cborrowman/Napco1632ArduinoMonitor/README.md

# Napco1632ArduinoMonitor
------------------------------------------------------------------------------
April 24, 2026

I've been running the Arduino MKR 1010 WIFI/Arduino MKR Ethernet combo for a couple years now and it's been fairly reliable. It does restart occasionally, which I think is due to the 8 second watchdog timer expiring due to some delay posting to the azure site I am collecting data. 

I don't use HTTPS because the handshakes were taking 7-8 seconds and require preloading a certificate trust chain that I would have to flash to maintain over time. You need to use encryption, so I found it to be much faster to encrypt data on the arduino using a hardcoded key and send the encrypted data over HTTP rather than attempting to do TLS directly on the Arduino. I'm willing to accept the risk of this for a hobbyist solution.

I wanted to have a cellular fallback and have spent time exploring options to do that. I looked at the [SparkFun LTE CAT M1/NB-IoT Shield - SARA-R4](https://www.sparkfun.com/sparkfun-lte-cat-m1-nb-iot-shield-sara-r4.html) although I never had much success with it. I could get a few connections and send a little data, but would also go through days of total failure. It never became a reliable option.

I also tried the [Arduino MKR NB 1500](https://store-usa.arduino.cc/products/arduino-mkr-nb-1500) cellular option and had similar results as the SparkFun. It worked occasionally but it then seems like a total failure. I think I even replaced the Arduino board at one point but never made much headway.

I recently came across the [Walter](https://www.quickspot.io/) cellular modem device. An ESP32 based board with WIFI and LTE. It worked right out of the box. I experimented with it for a couple months. Its software library was upgraded a few times and seems like a stable platform.

The idea occurred to me to build a cellular proxy device using the WalterModem. I would add a LAN connection and any devices in my house could send their payload to this device over LAN, it would attempt to repost the request via LAN, if that fails it would try WIFI, and if that fails it would fallback to Cellular/LTE. I spent a few months building and testing this. Looking at the entire picture, I grew dissatisfied with the proxy plan. It meant I'd have to provide battery backup power to all devices that need to send data, and likely some portion of the network, at least one router, in case of a power outage. While this could work, it seemed impractical and cumbersome.

I had a fairly complicated script for Arduino and the thought of rewriting it for ESP32 didn't sound like fun, so I initially did not consider porting my alarm monitor implementation to run on the Walter. I started experimenting with a W5500 LAN controller and once I got that working it seemed pretty straightforward to see if the Walter could handle the other IO needed for the alarm monitor.

The hardware interface was nearly identical to what I used on Arduino. Copilot with Claude Sonnet made the migration to Walter effortless. I started by having it create a detailed plan and it actually suggested several additions I had not considered, such as recording reboot reason and other diagnostic information. I also had it implement a number of test modes so I could confirm each of the transport platforms was working.

This schematic iteration shows routing both the alarm panel transmit and the keypad transmit data as inputs. I was using this briefly to sniff and compare the wire traffic. I ended up using only the panel transmit data for monitoring.

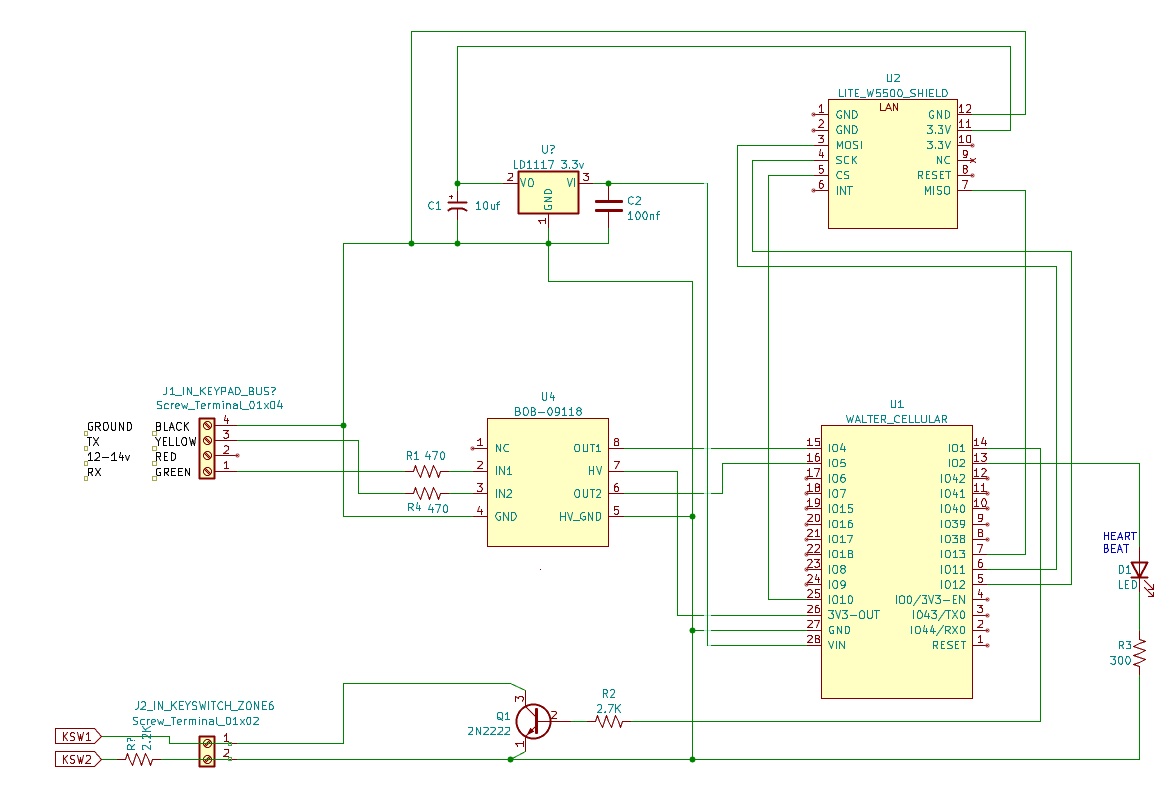
[picture p1: images/WalterW5500KeyswitchWithLTEFallback.jpg]
Walter With Fallback Schematic


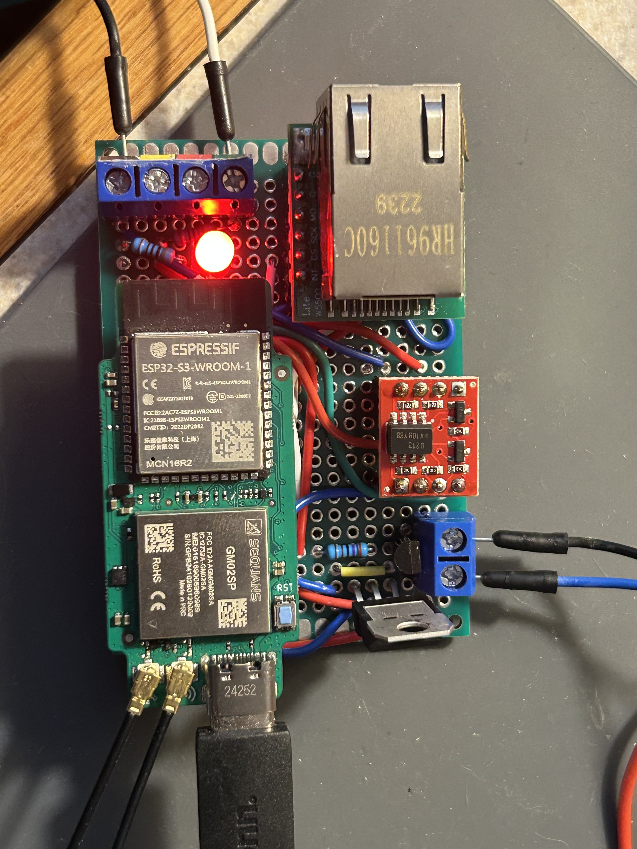
[picture p2: images/WalterW5500Fallback.jpg]
Walter With Fallback Photo


It took a little effort getting the transport fallback to work correctly. Fortunately I had a home internet outage at just the right time and was able to test. Of course the first tests failed but with a little work I ended up with a reliable fallback scheme. It tries to publish to the server first via LAN, if that is disconnected or fails, it will try WIFI. If that isn't online or fails it will then try cellular LTE. Worst case is about 6 seconds failing on LAN and WIFI. Running this for a couple weeks I still see some fail overs to cellular throughout the day.

I'm using a sim from [Hologram](https://www.hologram.io/). Minimal data usage is about $1 per month.

I really like the Walter and am thinking of other uses where I'd like to fallback to cell communication.

------------------------------------------------------------------------------
April 21, 2023

One day I was looking at other integrated alarm ideas and came across one solution that used keyswitch arming to trigger arming and disarming of the control panel. I wish I had found this earlier because it makes for a much simplier solution. Rather than having to read and write to the panel and also and inject my own commands in bewteen responses from a real keypad, all it has to do is monitor the panel output. Then to trigger arm/disarm it only needs to ground two pins on the panel.

I had an earlier prototype board sitting on the bench that was readonly and used just for monitoring. I experimented with using a simple transistor to pull the keyswitch contacts low it worked, so I turned this board into Schematic 6 and Prototype 6.

All the code I had previouslt could be used, except I didn't need any of the code to write commands back. Triggering the keyswitch just required a one second pulse to low on the digital output driving the transistor.

The last prototype has been very stable and has been running since December. I do seem to go through episodes of rebooting a few times a day, some days more than others. I think the issues are more about sending commands to the azure site recording alarm status. I think the reboots are ocurring because the command cannot be delivered to the azure site within 8 seconds. I don't think it is because the board is crashing and rebooting. I have an 8 second watch dog running, so if any command takes longer than 8 seconds, the board resets. I see 2 or 3 a day.

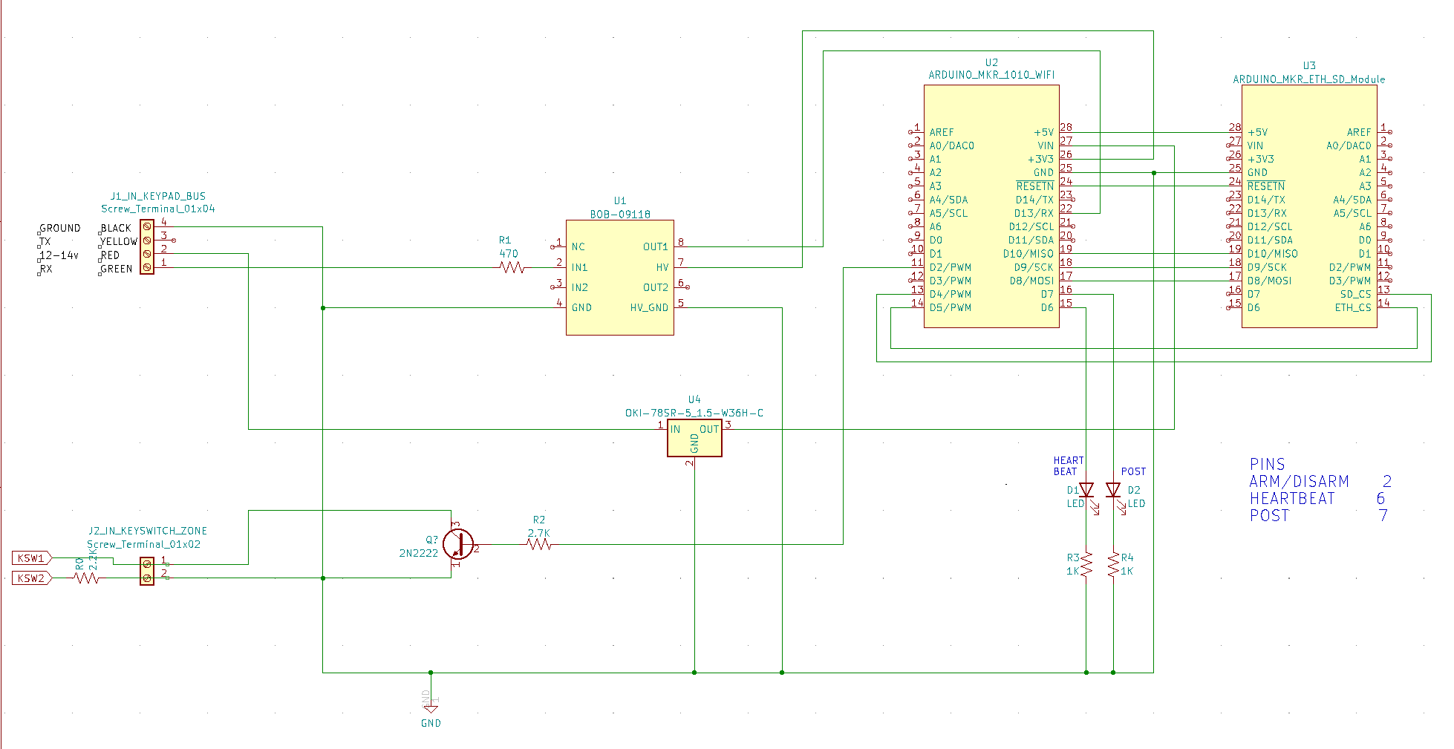
[picture p3: images/schematic6.png]
Prototype6


------------------------------------------------------------------------------
December 17, 2022

I've been experimenting with ethernet adaptors trying to find a reliable wired ethernet connection. I tried replacing the 7805 power supply with an OKI 78SR5 power convertor. This uses solid state switching to regulate power and won't have the same power usage as the 7805. I thought the 7805 was getting rather hot. I seem to have a problem with bootup power. I ended up just using a USB power supply for the Arduino & ethernet.

This lead to Schematic 5 and Prototype 5 shown below:
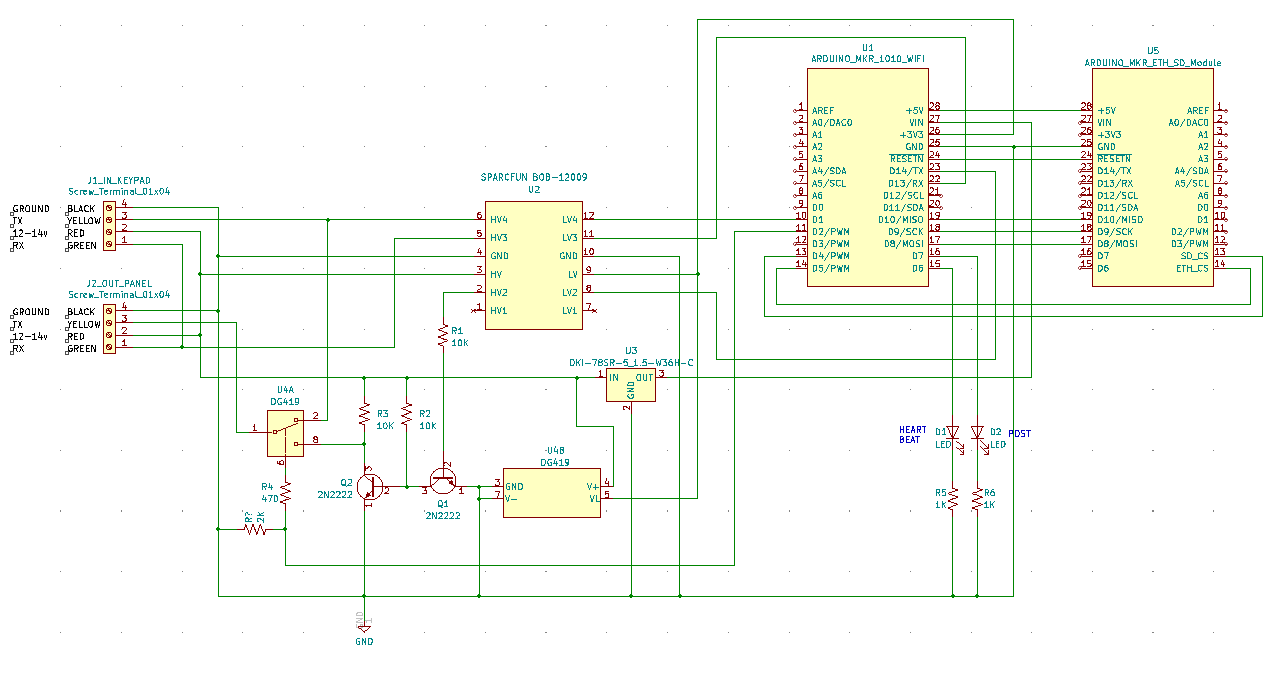
[picture p4: images/Schematic5.png]

<br/>
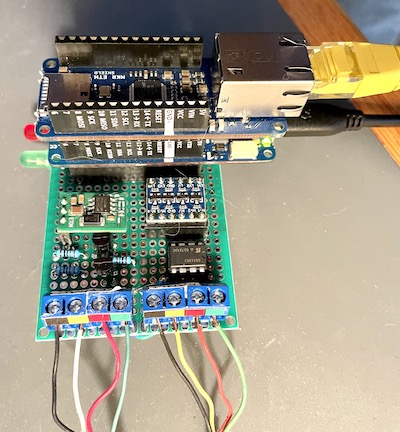
[picture p5: images/Prototype5.jpg]
Prototype2


I had added two LEDs to show a heatbeat blink and a post light. This provided some feedback that the unit was operating. I didn't realize at first that I had a conflict between the Arduino and the ETH shield. I had an LED wired to digital pins 4 & 5. The MKR ETH shield was using pi 4 as CS for the card reader.

I think this was the source of some of my problems. I had code turning the LED on and off and this was likely causing CS signal conflicts.

------------------------------------------------------------------------------
November 6, 2022

The alarm monitor has been running for several months using WIFI to communicate with the server site. Once I added a routine to reset and restart the WIFI module when it cannot connect, it’s been reliable. 

It reports status every 5 minutes if there is no other status to send, so the server will detect if the alarm is offline if it doesn’t hear anything for 6 minutes. I was getting offline reports once or twice a day, but it would always be back online within 1-2 minutes. I’m not sure of the cause of this. It could be WIFI connection, although I’ve got a Google mesh network that seems very reliable. 

It could be a bug that prevents it from sending on time. Monitoring the log for extended periods of time I was surprised to see how much time it was taking to send a message via SSL.

WIFI message sends over SSL were taking 3+ seconds, which seems like a very long time. I measured a few that took 4-7 seconds. I had to set the watchdog timer to 8 seconds to avoid resetting the monitor if the send takes too long. I don’t think this was the cause of going offline because the monitor sends a power on message when it boots and there was no log of this.

I figured I would switch to wired ethernet since i already had a network line run to the panel. I purchased an Arduino MKR ETH Shield which plugged directly into the Arduino MKR WIFI 1010 I am using. I thought this would be a simple change to the code. 

Although the MKR WIFI 1010 has a special ship to hold certificate secrets, I didn’t find any libraries which could use this for Ethernet. I did eventually find a library that could handle SSL over ethernet. These messages were taking over 7 seconds to make the SSL connection! I’m surprised at the state of SSL. it seems current SSL encryption requires too much computation. Regular HTTP is pretty quick, usually less than one second. 

I considered just using HTTP, however the Azure Static Web Site doesn’t accept HTTP connections. I started experimenting with doing some lightweight encryption on the Arduino and found a library that could do AES 128 quickly. This would be good enough for alarm status data. I created an Azure function that accepted an encrypted POST from the Arduino on HTTP and would decrypt and forward to the normal status API.

This allowed posts to occur under one second, typically around 600ms including the encryption. This was good enough.

I plugged in the ethernet shield to the live monitor and updated the software. It was working for for about one hour when it went offline. It didn’t come back online like before. I connected the computer to view the log output and it booted up and started running. I suspect the 7805 voltage regulator powering the Arduino just could not handle both the Arduino and ethernet shield. It got too hot and shutdown.

I plugged in a USB power supply to the usb cable to take the load off the voltage regulator. It ran for about one day and then stopped, and again the Arduino appeared to be hung since it booted when I connected the mac. 
 
I put the WIFI code back in place and proceeded to investigate power and ethernet options.

------------------------------------------------------------------------------
June 1, 2022

Hit an important milestone today! I can connect to a website that displays the panel buttons virtually. I can enter codes and arm and disarm as needed! Panel responds immediately. Switching hardware is working perfectly.

Here's a couple photos of the website - works on my mac and iphone:

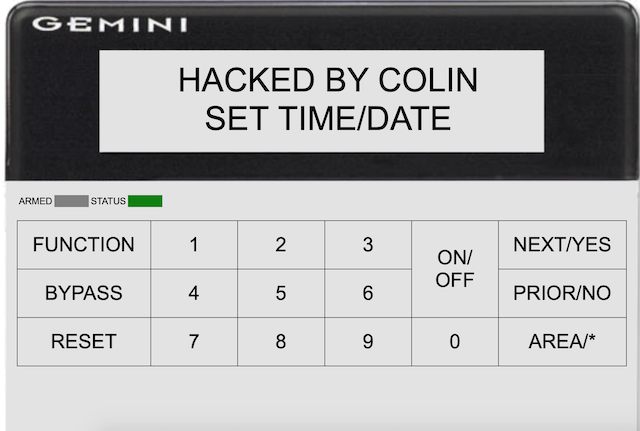
[picture p6: images/disarmed.png]

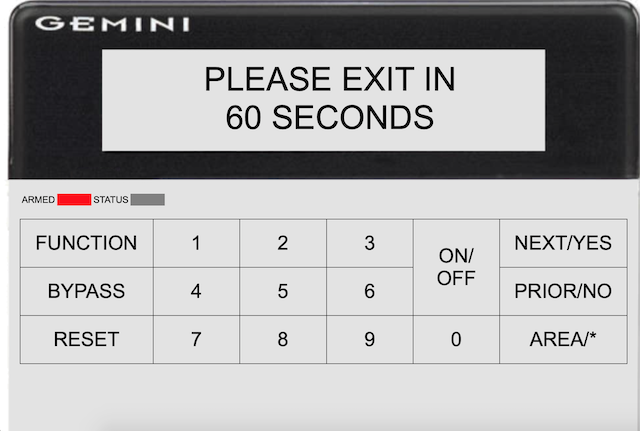
[picture p7: images/armed.png]


Below is a screenshot of the transmit line and the switching signal. At this point I am transmitting a custom command to the panel from the website. For example, to arm or disarm:

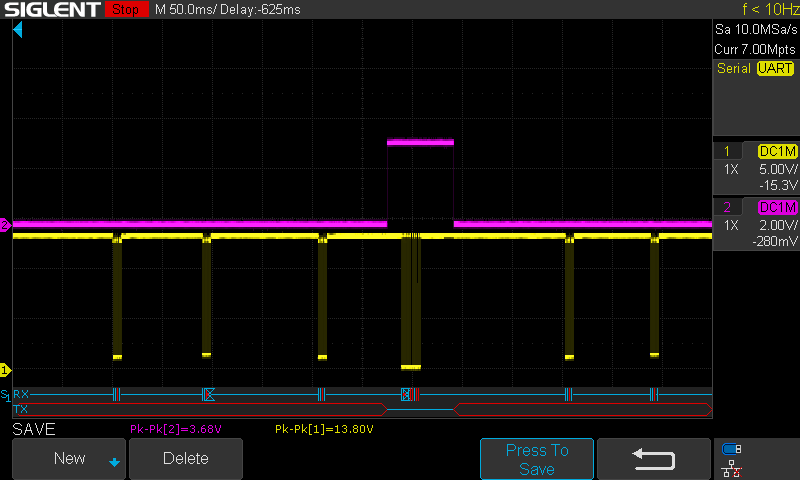
[picture p8: images/switch send 1.png]


Now I can finish up the reporting side of the software and try to connect a dispatch API.

------------------------------------------------------------------------------

May 24, 2022

I was thinking about the last prototype and that it is dependent on having the Arduino reliably send the intercepted keypad commands all the time. Only a few missed message ends up showing a system fault on the alarm.

As I thought about it, 99.9% of the time, I want the keypad messages to go straight through. Only once in a while will I want to send my own custom commands, to arm or disarm, for example. What would be really nice is to have some kind of switch that lets the the keypad commands go through to the panel except in the case that I want to send my own custom command, I could flip the switch, send my command, then restore the switch for normal operation. 

I researched a little and found what looked like a suitable component, a CMOS analog SPDT switch IC from Vishay DG419: https://www.vishay.com/docs/70051/dg417.pdf

Reading about this chip, it seems to provide what I want. It’s a switch that can work in both directions and is controlled by a digital signal. All I need to do to use it is one more digital output on the Arduino to control this switch. 

I ordered a couple of these switches and when they arrived I wired up a breadboard circuit to test it and it seems to work! This lead to a new schematic and prototype #4:

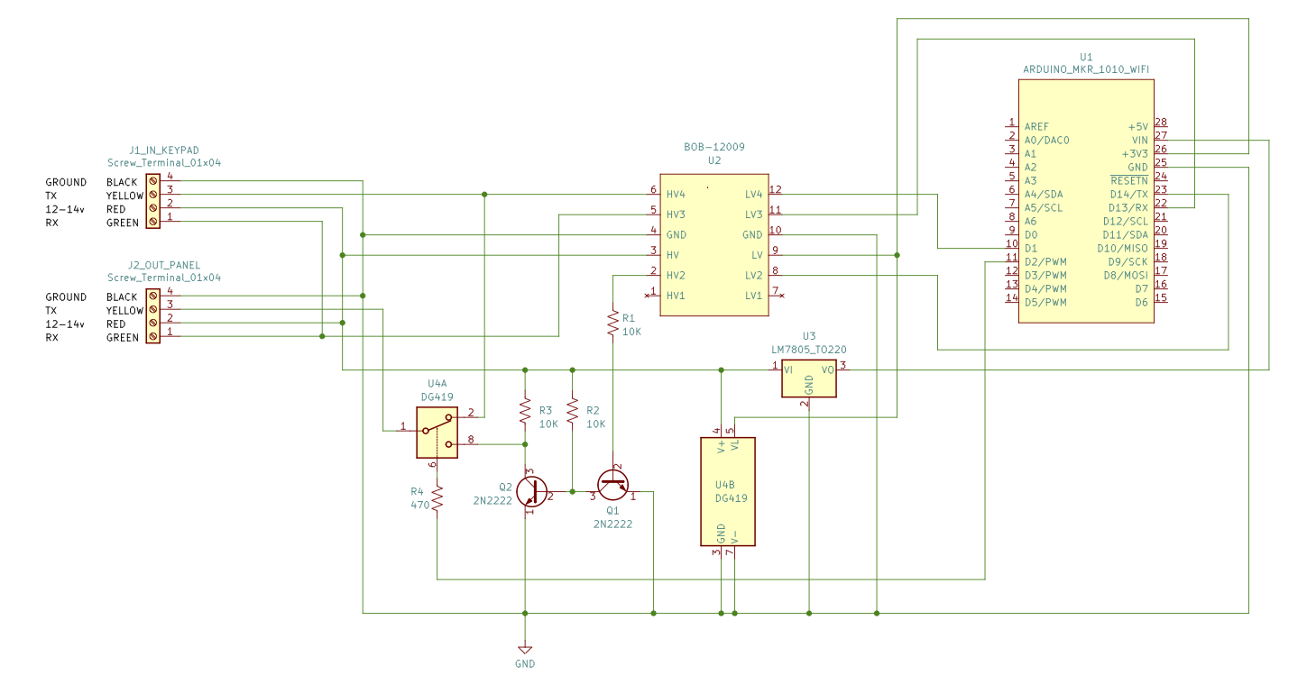
[picture p9: images/Sparkfun level converter output trans with switch.png]


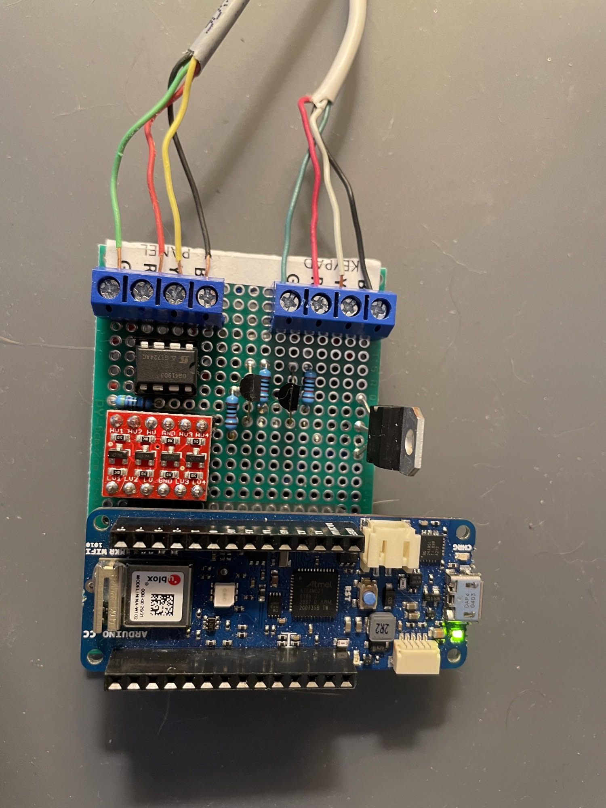
[picture p10: images/prototype4 front.jpeg]
Prototype2


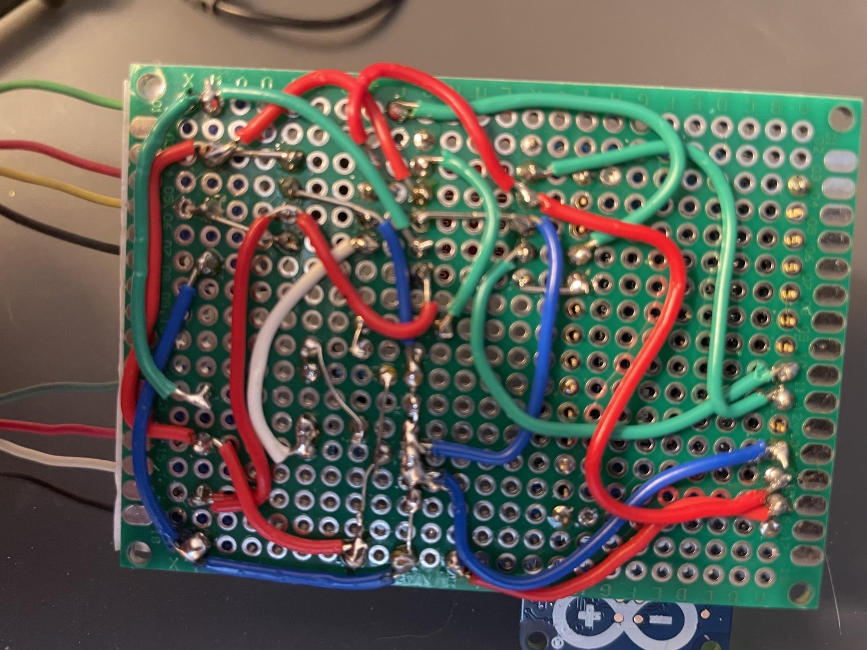
[picture p11: images/prototype4 back.jpeg]
Prototype2


I modified the test software I was using that was passing the keypad commands through to the panel. By default the switch is in its normally closed position and keypad commands go directly to the panel bus. I made it so that every 10th response sent by the keypad, will trigger the switch and the Arduino generated message will be sent to the panel bus.

This can be seen below. This image shows the green RX from the panel with the switch control. 

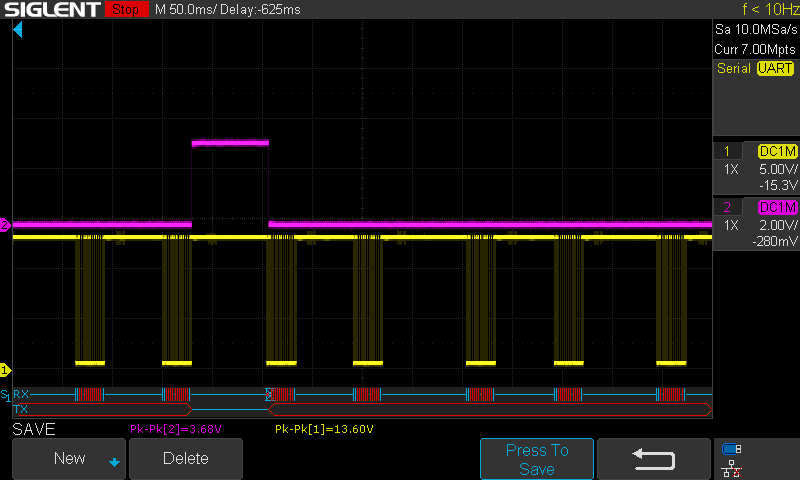
[picture p12: images/bus green rx with switch control.png]


This image shows the TX to the panel with the switch control. You can tell it is sending the Arduino message because it is slightly longer. 

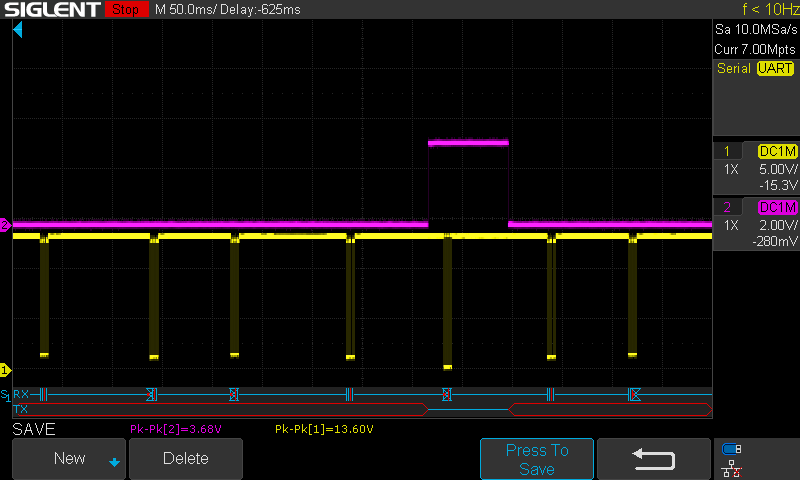
[picture p13: images/bus yellow tx with switch control.png]


I made a combined image below that shows both signals with the switch control. This gives a sense of the overall timing.

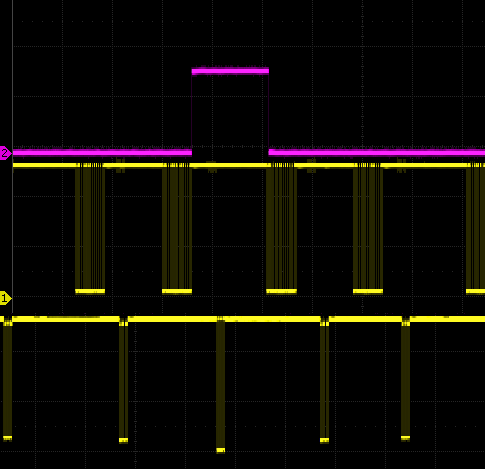
[picture p14: images/combined with switch control.png]


Now I can clean up the software to send just the custom commands and remove stuff I don't need. This seems like the ideal solution so far.

------------------------------------------------------------------------------
May 19, 2022

I had to rework the two way prototype as it didn't seem to reliably be able to send the keypad commands on the bus. The level converter seemed to work fine on the breadboard, but it appears it just couldn't push the output hard enough.

Below shows both the data from the panel and the transmission bus on the bottom. Both keypads output can be seen here. The longer yellow transmission line is second non-intercepted panel and the shorter is the the intercepted panel with the transistor driver. Notice the scope can only decode the non-intercepted panel.

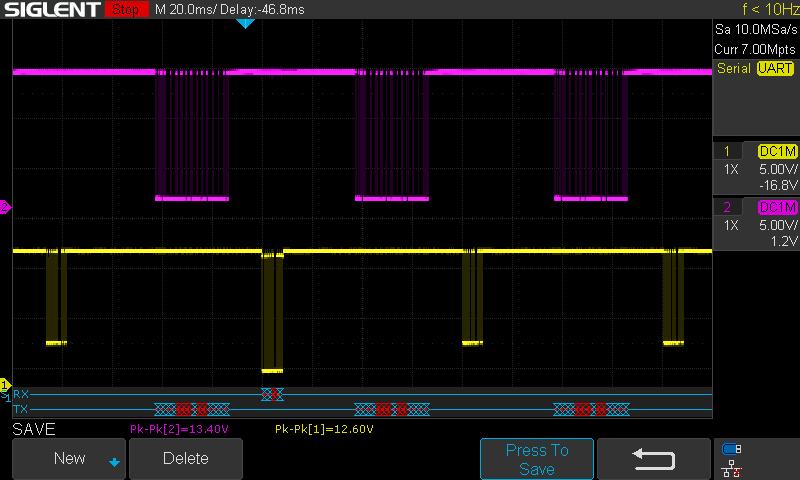
[picture p15: images/sends.png]


Below is a good send, which is coming from the other non-conncted keypad. It shows 12.6 volts.

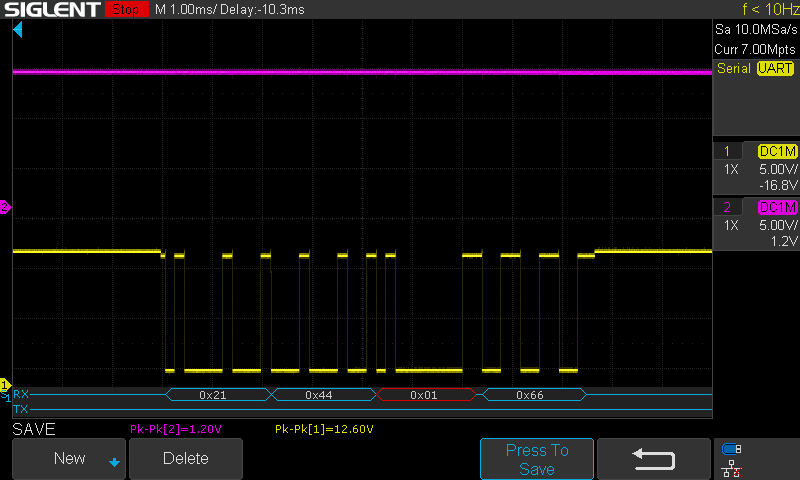
[picture p16: images/good send.png]


Below is a bad send, coming from the level converter. Notice the voltage here is only 9.8 volts. I believe this was the cause - it wasn't driving the output enough to be reliably recognized. Even the scope could not decode the signal.

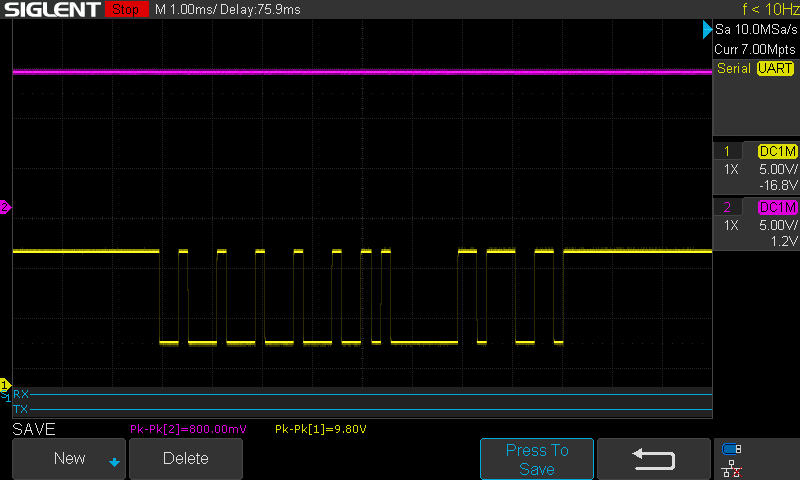
[picture p17: images/bad send.png]


I ended up adding a darlington transistor pair on the output which seems to fix the drive problem. Now the intercepted panel command seem to have better strength than the second panel. Both the scope and panel can decode both signals.

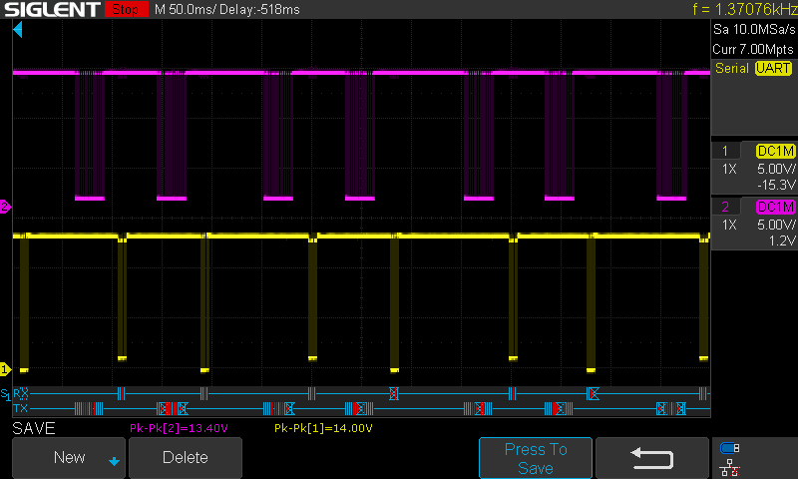
[picture p18: images/with trans output.png]


Here's the new schematic:

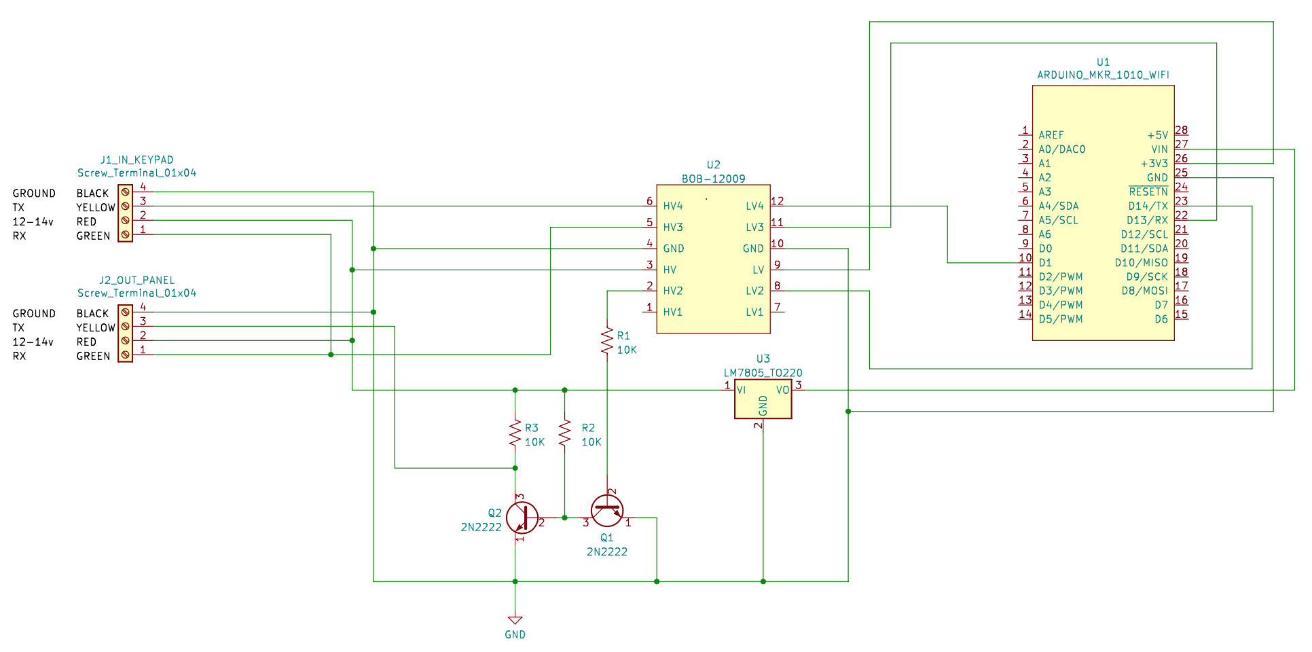
[picture p19: images/SparkFunLevelWithOutputTrans.png]


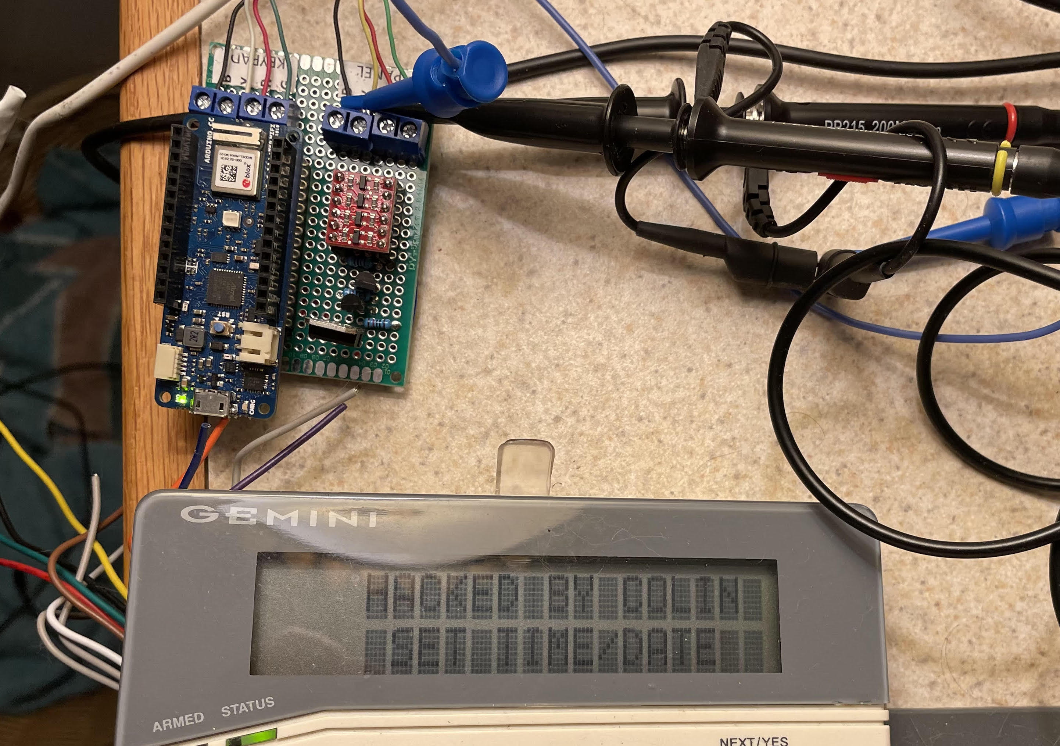
[picture p20: images/prototype3.jpeg]
Prototype2


This has run for 24 hours without error so it looks like it is time to work on the software for the intercepted version. I'm planning on having the arduino listen for HTTP server requests and return a simple webpage that will allow interaction with the panel, for example sending arm/diarm codes, reset, etc.

------------------------------------------------------------------------------
May 8, 2022

I've been running the monitoring prototype for about 4 months connected to my live alarm system. Initially I had to make a few adjustments to the code to handle repeated Wifi disconnects. Not exactly sure of the cause, since Wifi environment is pretty stable, but some reconnect code seemed to allow it to cover quickly.  

I have Ardino reporting all alarm panel messages to an application running in Azure which collects data to a SQLite database and allows me to review data. 

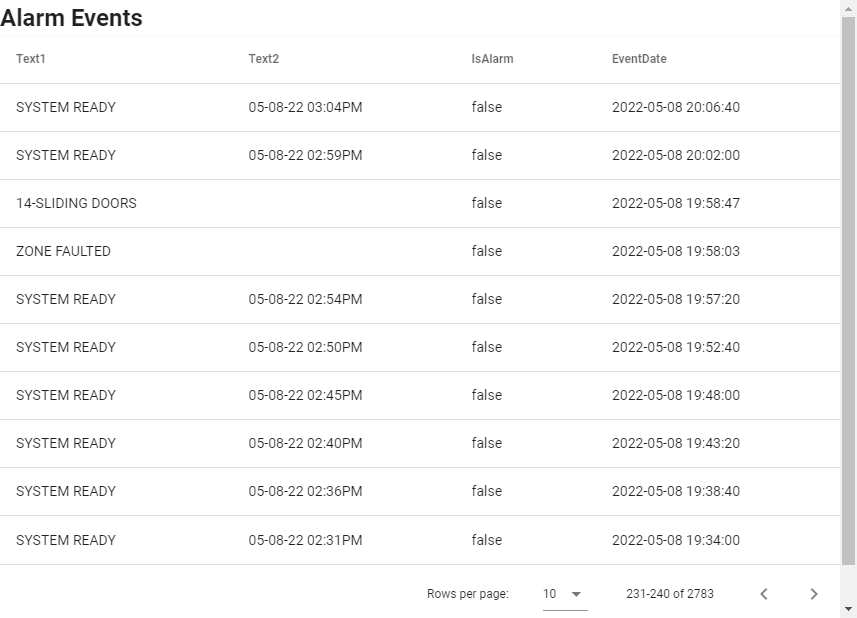
[picture p21: images/alarm website.png]


It reports status every 5 minutes even if there are no changes. Timer functions in Azure can detect if panel hasn't reported in and will send Device Offline notice to me. I don't have it connected to a dispatch API yet, but that is about all that is left to complete in the monitoring site. Below is an overview of the architecture:

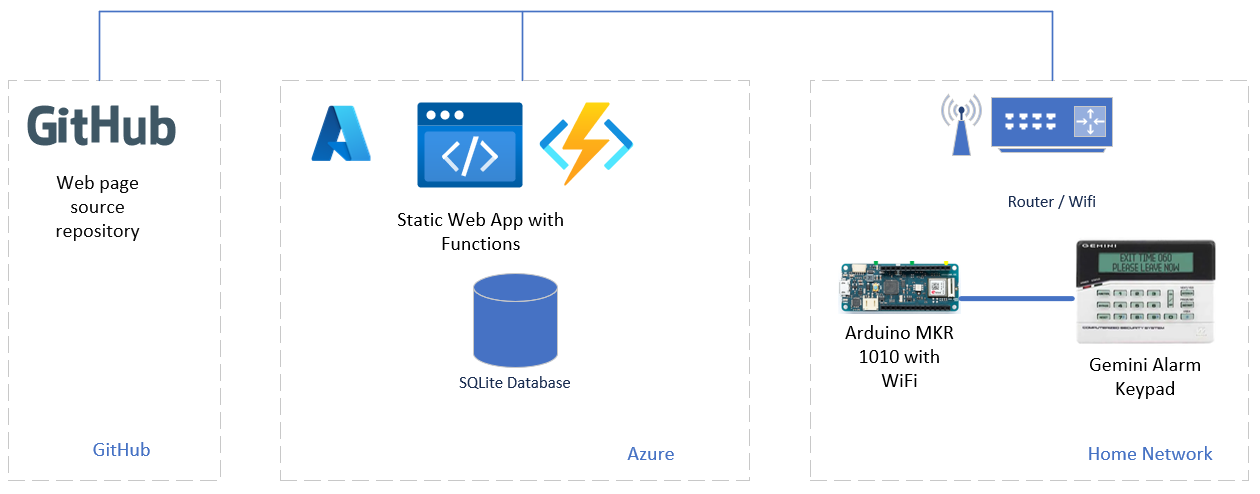
[picture p22: images/system architecture.png]


I'm thinking about building another prototype as I really would like to be able to interact with the alarm panel remotely. Mainly to be able to disable prior to entering the house so as to avoid waking everyone up after early morning outing.

I've been experimenting with a different device from SparcFun which makes the interface to the alarm panel less complex. SparkFun Logic Level Converter - Bi-Directional approx $3.50 each (https://www.sparkfun.com/products/12009)

I will continue testing this device and will post updates shortly when I have it running against the live panel.

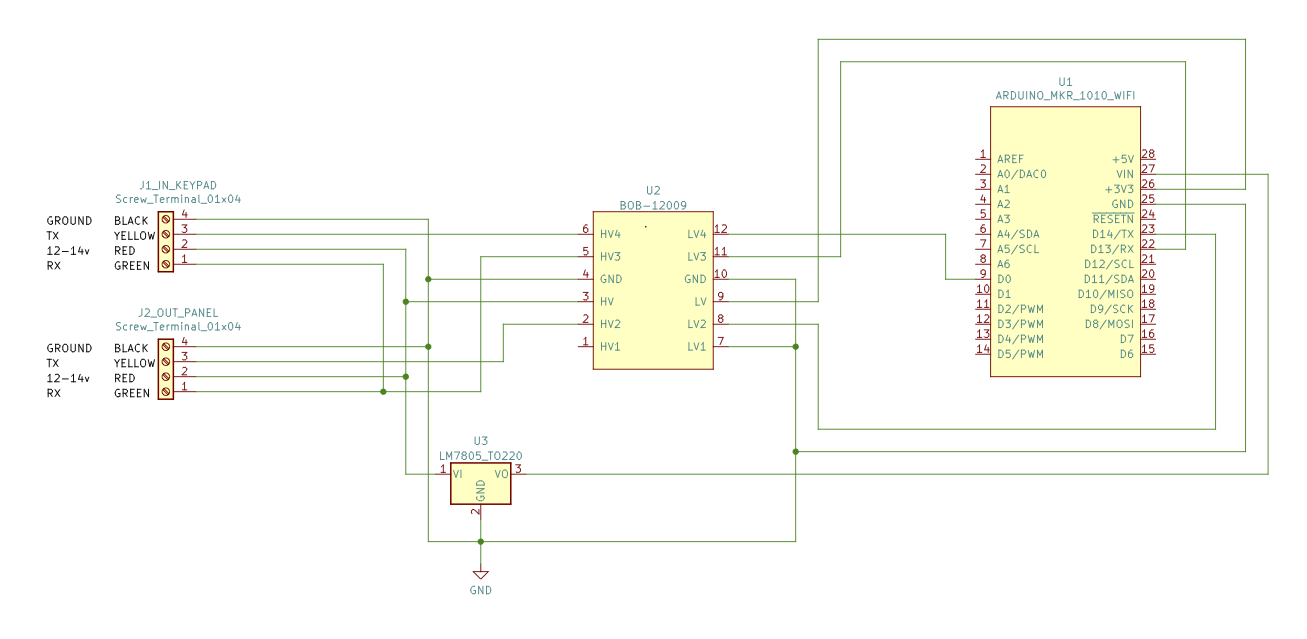
[picture p23: images/SparkFun LCTwo RX.png]


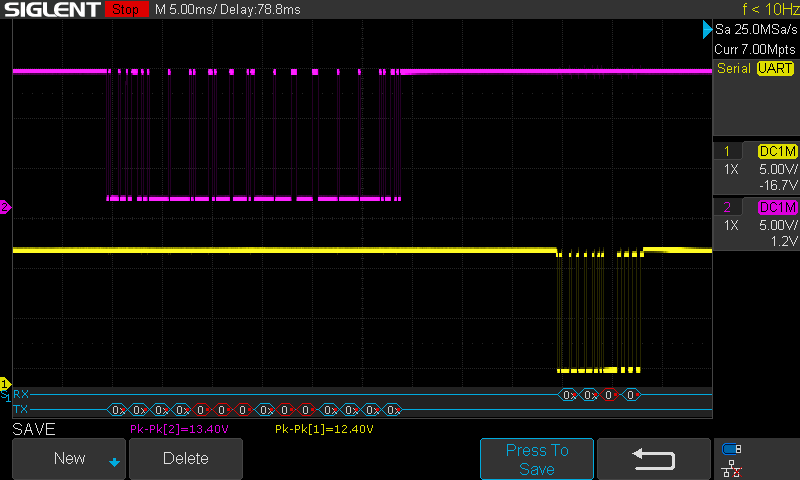
[picture p24: images/SDS00007.png]


------------------------------------------------------------------------------
December 22, 2021

I wanted to get my prototype into testing and see how reliable it was, but I was reluctant to hook it up to my live alarm panel. Since it depends on intercepting panel messages and resending them on the bus, it seems like any issues could interrupt normal operation and at the very least cause errors. And alarm errors ocurring at 3AM would not be much fun. 

So I thought about building a new prototype that worked in listen only mode on the alarm bus. This way there wouldn't be any chance it interfers with normal alarm operation. I modified my design a bit to intercept only, see below:

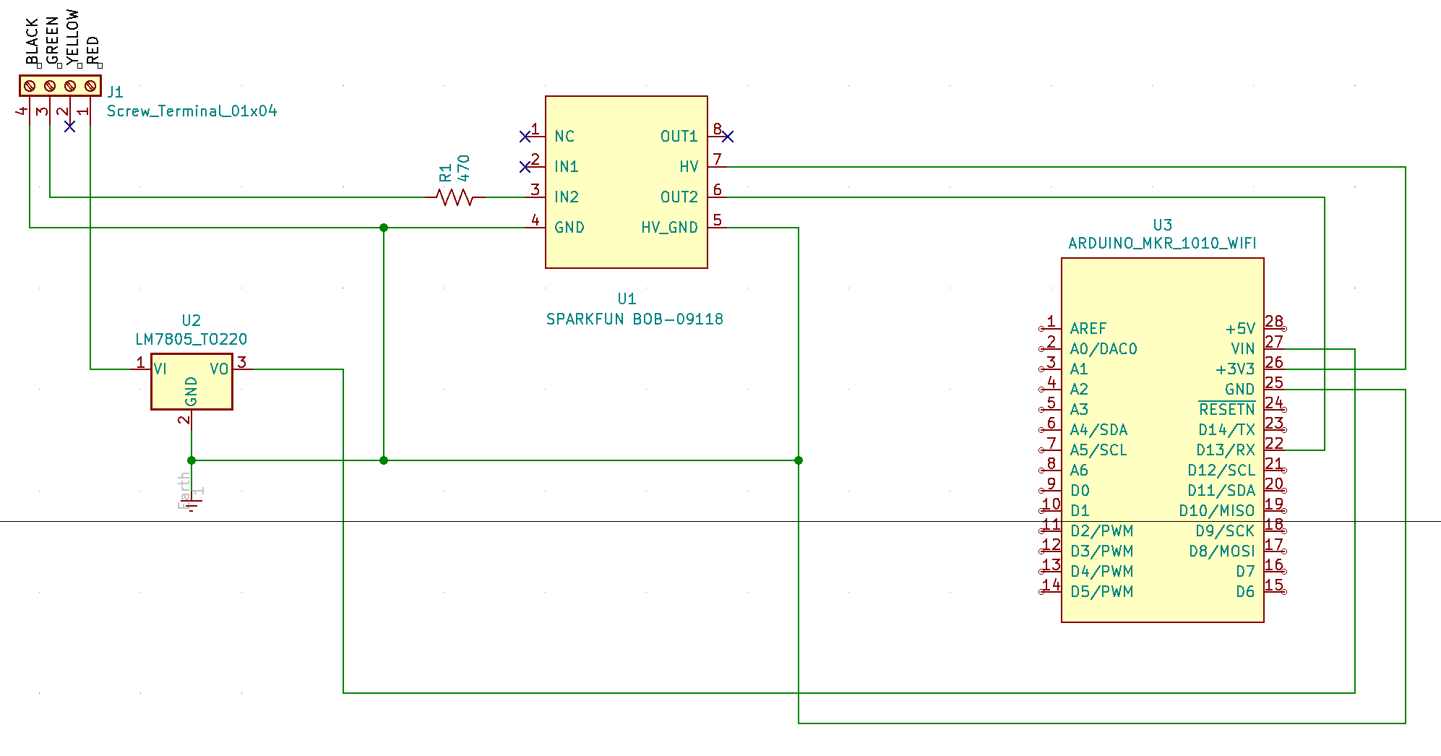
[picture p25: images/prototype2schematic.png]
Prototype2


And built a prototype:
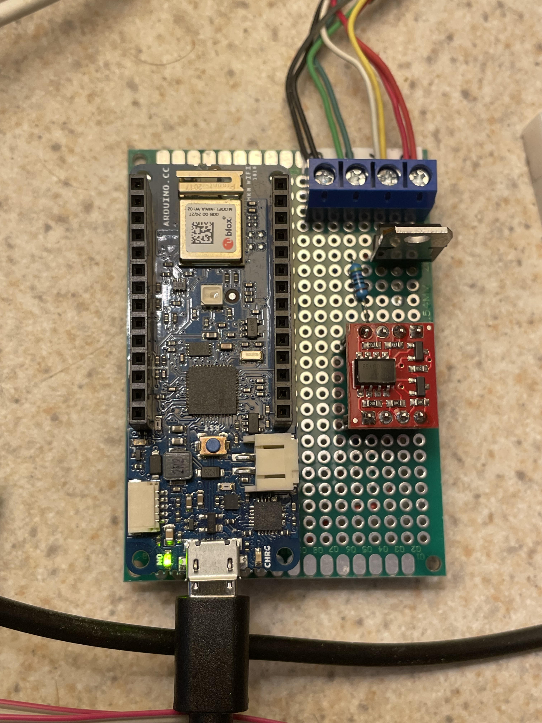
[picture p26: images/proto2front.jpeg]

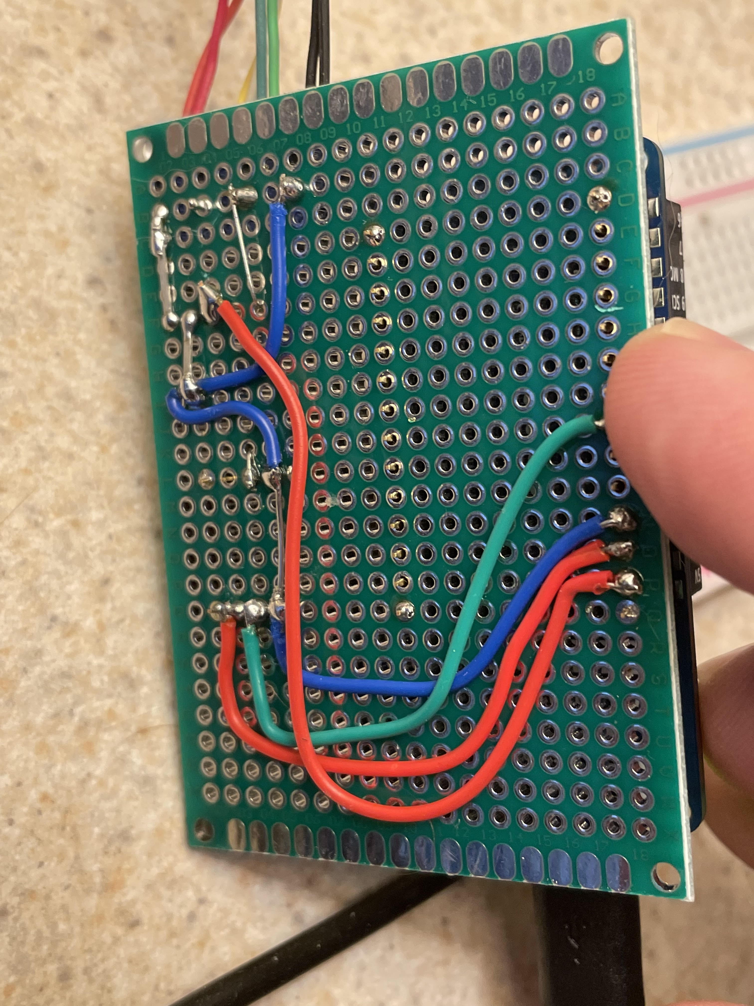
[picture p27: images/proto2back.jpeg]


I've had this running for a week or so on my test panel with no issues. I was curious how the voltage regulator would work out to power the arduino. So far no problems. When working with my first prototype I actually ordered and experimented with 2 different isolated voltage regulators (RECOM RM-1205S/H and Murata NMA2405S) which were supposed to be able to convert the 12v from the panel to 5v for arduino.  I had no luck with either of these. I assume I'm doing something wrong, but they either output more than 5v (like 6-7v) which might fry the arduino, or they output practically nothing. I went back to the non-isolated 7805 for this attempt.

This prototype came together quickly and I soon had it monitoring the alarm bus. This allowed me to work on the server side components, an azure website that would record the alarm events and dispatch messages or alarms if detected. 

------------------------------------------------------------------------------
October 26, 2021

This is my current state. I've built an interface board to go between the napco keypad and the alarm panel
that can intercept keyboard commands, forward them to the panel or send alternate commands to the panel, and finally monitor requests from the panel. This doesn't require programming an extra keypad; it can plug into an existing keypad.

Below is a diagram of the intercept concept
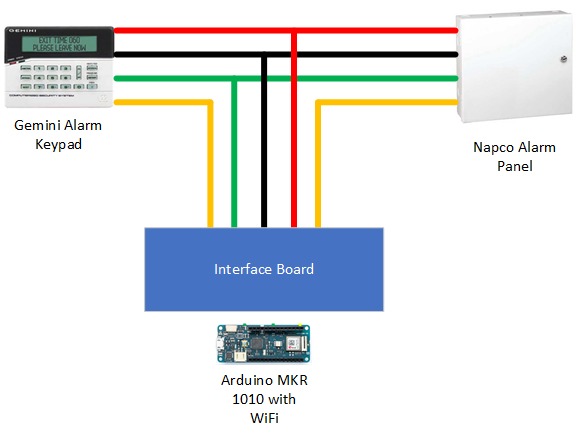
[picture p28: images/Intercept Diagram.png]
Intercept


This interface board uses an Arduino MKR 1010 WIFI and 2 optoisolator boards from Sparkfun (https://www.sparkfun.com/products/9118). This Arduino model can program digital pins to be additional serial port, so I have two receive and one send.

I had many previous versions both isolated and non-isolated. The first iteration is at the bottom of this description. My next attempts included isolation using with some 4N35s. This worked but wasn't great. I tried one of the Sparkfun isolator boards and it had much better resulting signals (it uses a ILD213T chip plus transistors). When they sent me an extra one by mistake I decided to go fully isolated in both directions. You can also get chinese versions of this board for less than $1. It took a little more circuitry and a couple transistors and resistors before I could reliably drive the transmission line to the panel. 

Below is the interface board prototype
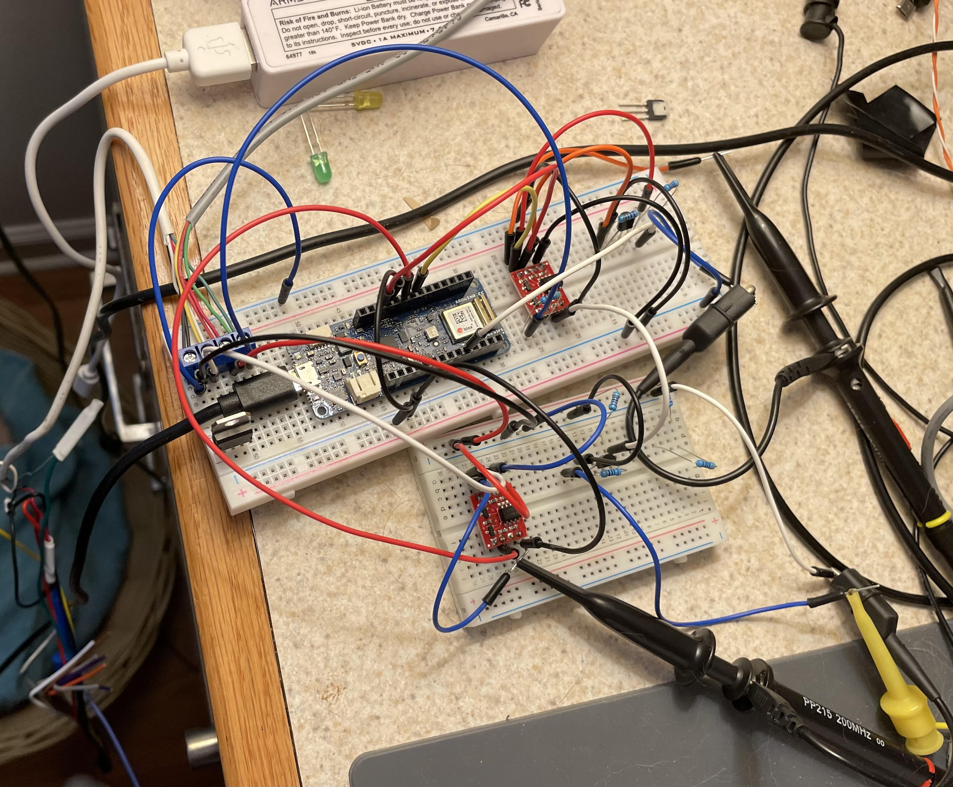
[picture p29: images/prototype.jpeg]
Prototype


Below is the interface board breadboard
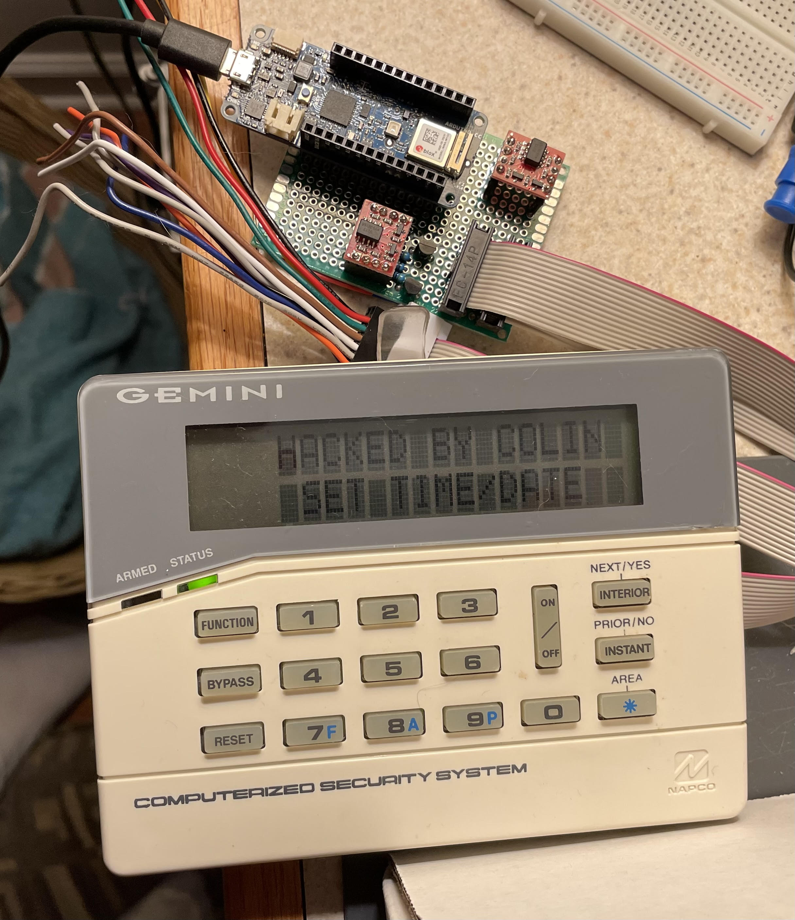
[picture p30: images/breadboard.jpeg]
Breadboard


Below is the schematic I'm using currently. I built this on to a breadboard and used a couple ribbon cables to connect to the keypad.
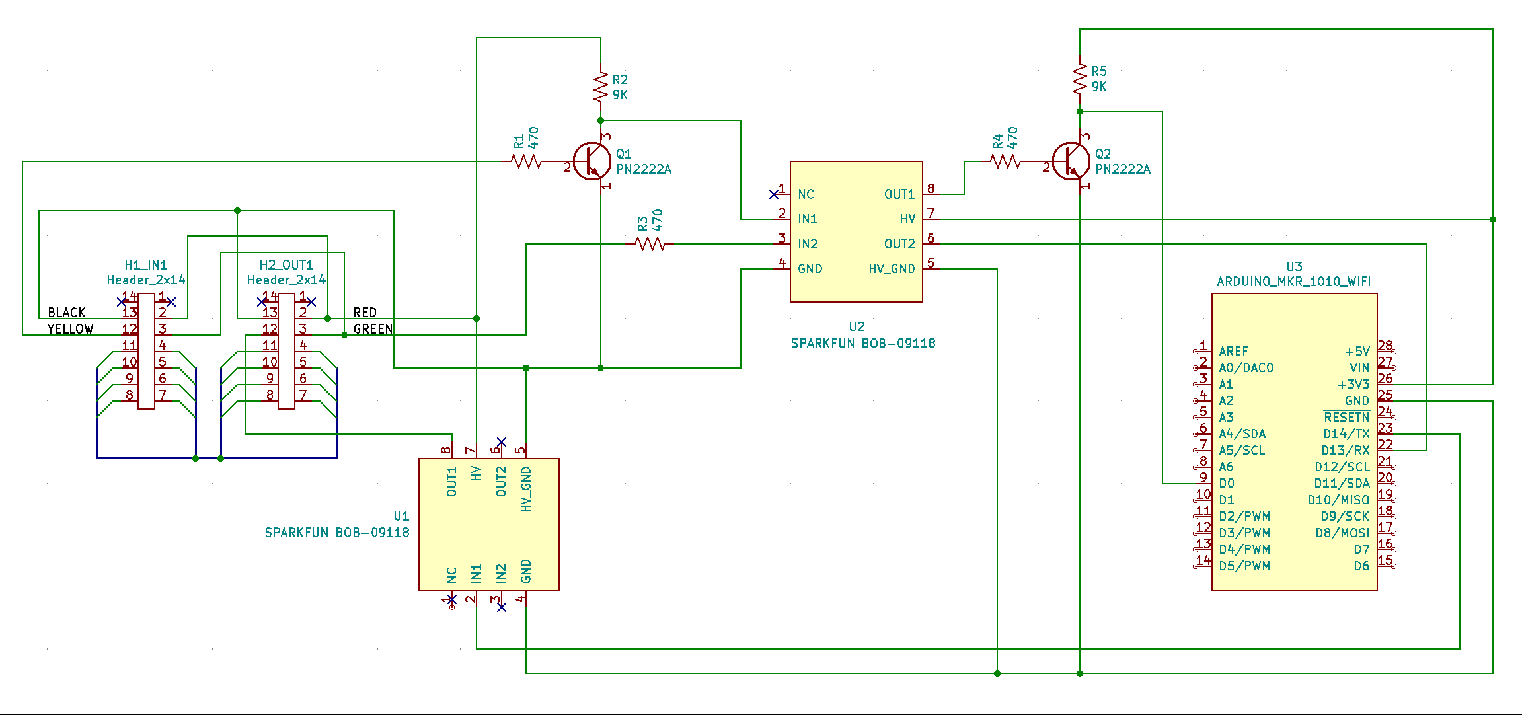
[picture p31: images/Napco Intercept Module using Sparkfun Optoisolator Schematic.png]
Schematic


Below is an example of the signals showing transmission to the panel at the top in purple and data from the panel on the bottom in yellow. 
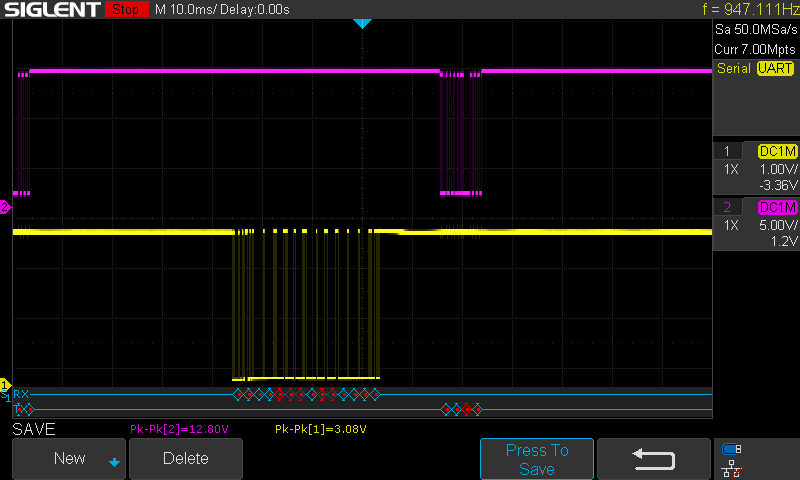
[picture p32: images/Napco Alarm RX TX.png]
Oscilliscope


The yellow line shows data coming from the panel. Requests are identified for each keypad. The keypad will respond to requests identified for the keypad. With the intercept setup, messages from the keypad go through the arduino and are normally just forwarded to the transmit line. If we want to send a message on behalf of a specific keypad, that can be done by sending our own message instead of the one sent by the keypad. 

I'm currenty working on software for both the Arduino as well as some cloud services to receive updates and dispatch alarm notifications.

More details to follow...

------------------------------------------------------------------------------
September 29, 2021

This was my initial attempt at monitoring communications frmo the Napco panel.

Arduino Sketch to monitor serial communications from Napco 1632 Panel to keypad

This effort was inspired by: https://www.wizzycom.net/napco-1632-virtual-keypad-project

Use to analyze data from RX and TX to keyboard from Napco 1632 panel. I used Arduino MKR WIFI 1010 which has separate serial port identified as Serial1. Connect to wiring diagram below and run monitor to see data received. Reconfigure using next wiring to see data sent by keypad. There is a good chance second diagram works for both. I tried the receive voltage divider first and it worked, but did not work for sent data.

    Monitoring data received by keypad:

                      1K               300 ohm
    KEYPAD GREEN ---/\/\/\/\----.----/\/\/\/\------ ARDUINO GROUND PIN 
                                |
                                |
                       ARDUINO PIN 13 -> RX

    Monitoring data sent from keypad:

                        9K               3.1K
    KEYPAD YELLOW ---/\/\/\/\----.----/\/\/\/\------ ARDUINO GROUND PIN 
                                 |
                                 |
                        ARDUINO PIN 13 -> RX

Arduino Sketch: https://github.com/cborrowman/Napco1632ArduinoMonitor/blob/main/ino/SerialPassthrough.ino

------------------------------------------------------------------------------
All information provided is for entertainment purposes only and you should use at your own risk. Nothing presented here is intended to suggest this could become a reliable life-safety monitoring device. 

<!--  https://hits.seeyoufarm.com/#badge  -->
