cborrowman/Napco1632ArduinoMonitor/images/Screen Shot 2023-04-22 at 7.21.25 PM.png

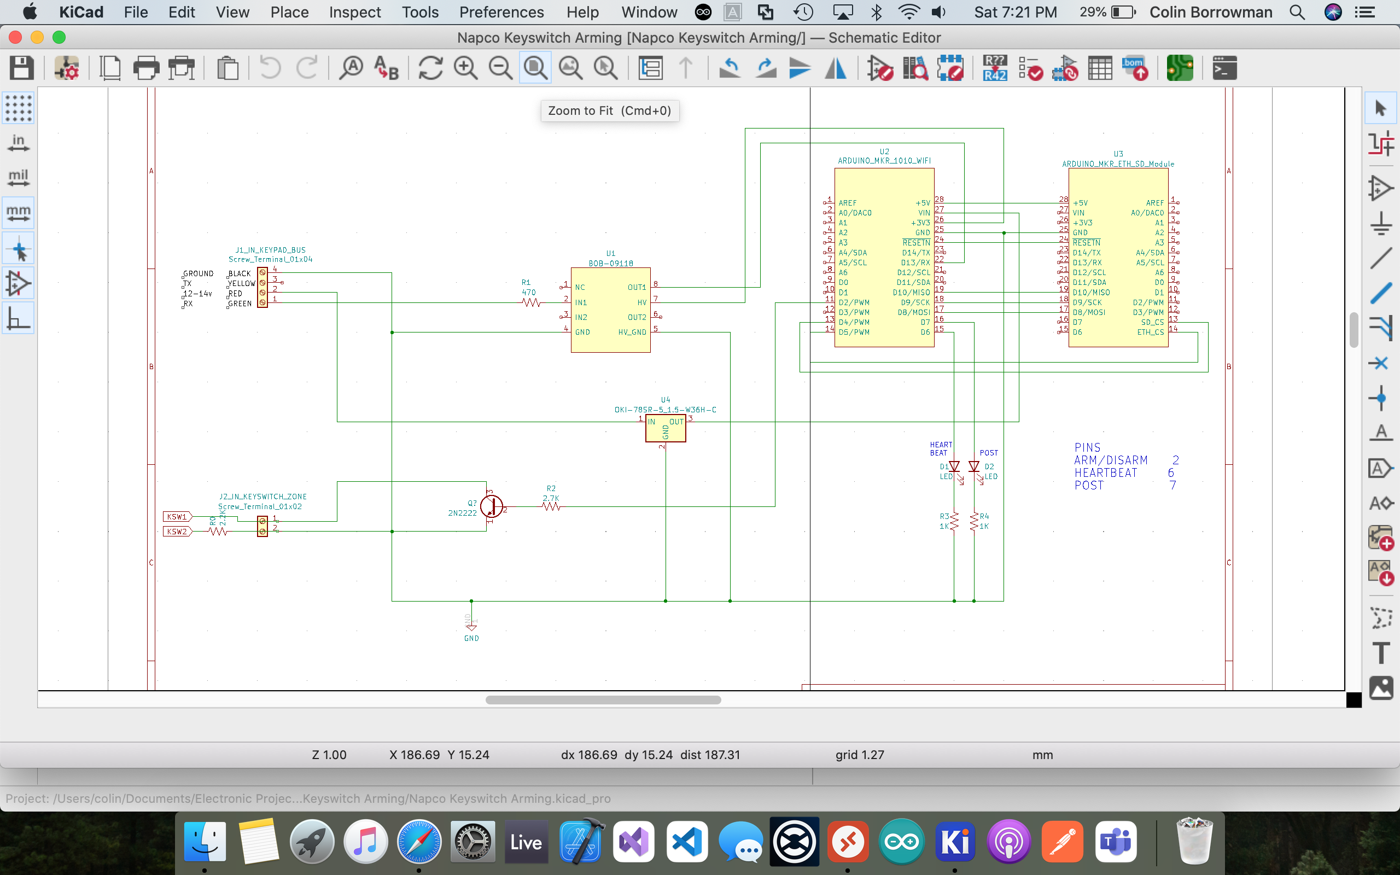
images/Screen Shot 2023-04-22 at 7.21.25 PM.png
