cborrowman/Napco1632ArduinoMonitor/(threads)

Thread 1 (2022-05-06):

Status?

bigscout79, 2022-05-06:
Still running strong? I'm going to try to follow your lead and use this.  I have a 32zone system that works great, but need to plug it into HomeAssistant. Thanks for posting your work!

bigscout79, 2022-05-09:
Thanks!  Would you still recommend the same hardware components? I'm going to start sourcing stuff if so.  This'll be my first arduino foray.  I have a few rpi's and developed middleware in java/.net for 15 years, but I'm a little weak on the hardware side.

cborrowman, 2022-05-09:
I've been happy with the monitoring prototype - schematic shown under Dec 22, 2021. This used one onto-isolator and one resistor:
SparkFun Opto-isolator Breakout (https://www.sparkfun.com/products/9118)

I'm now experimenting with being able to send and receive using:
 SparkFun Logic Level Converter - Bi-Directional (https://www.sparkfun.com/products/12009)

If you're going to get one of the SparkFun devices, go ahead and get a few of each, they're pretty cheap. I've been happy with the Arduino MKR 1010. It has the ability to import an SSL certificate so you can have secure communication to your backend, which was important to me. It also had a lot of flexibility with RX/TX ports, allowing use of 2. I'm still up in the air about WiFi vs. wired ethernet. I did get a couple cheap LAN modules which I might try connecting to see if they are any more reliable than WiFi.

bigscout79, 2022-05-09:
Sounds good - I'll start with those.  I am liking the "monitoring only" option.  I am bringing over a lot of smarthome devices from the last house and finding that my consumer gear is oversatured with 100 devices on the network - about half are wifi.  I am looking to go ethernet if possible as it has proven to be reliable on my present network.  I'm not too concerned with security locally as I keep my smarthome IOT isolated, and will likely vlan this into it's own as well.  I appreciate the advice, I'll start sourcing and then send some pictures too.

Thread 2 (2022-07-11):

Virtual keyboard with ESP32 and Gemini GEM-K2AS

zonehun, 2022-07-11:
I'm happy to found this project! What you do is great and I'm looking for to do the same but with an ESP32 and a GEM-K2AS keypad.

The Arduino code is just for sending bytes (I'm right?). How can you read out the information from the keyboard?

The ESP32 has a TX and RX pins - but if the signal is too weak it also has digital pins as well. I have some experiences building circuits but I'm mainly an sw developer. Making my home smart, the only thing is left to make my old, wired security system a bit smarter. Wanted to arm and disarm remotely and get the current status of my alarm. I plan to make it work with Homekit via a Homebridge plugin.

dgrnbrg, 2023-06-27:
Hey @zonehun, I am a hw and sw dev who is in the same boat as you. Do you have a napco system you're trying to make a virtual/local controller for as well?

I found this, which seems to be a minimal java implementation of parts of the serial protocol: https://github.com/poflynn/jGemNap

I'd like to make an ESP32/esphome device that plugs in to the security system, because I want to read the zone info, arm, and disarm without using the napco app or keypad.
