cborrowman/Napco1632ArduinoMonitor/(commit log)

2026-04-25 Fixed schematic
2026-04-25 Updated schematic
